Sugawarakana/Battery-Changing-Measurement/calibration/Cap.xlsx

K1 | K5 | K6 | AVG | std_avg | d | 1/d | Cap 0 | Cap 1 | Cap 2 | Cap 3 | Cap 0 | Cap 1 | Cap 2 | Cap 3 | 1/d
0 | 0 | 0 | 0 | 0 | 0.002 | 500 | 13.67882 | 13.15229875 | 13.82879 | 13.7749 | 1.367882e-11 | 1.315229875e-11 | 1.382879e-11 | 1.37749e-11 | 500
81.7 | 68.7 | 61 | 70.46666667 | 7.046666667e-05 | 0.001929533333 | 518.2600283 | 13.936275 | 13.3447125 | 14.08443625 | 13.98676875 | 1.3936275e-11 | 1.33447125e-11 | 1.408443625e-11 | 1.398676875e-11 | 518.2600283
144.3 | 142.5 | 130.4 | 139.0666667 | 0.0001390666667 | 0.001860933333 | 537.3647632 | 14.19620222 | 13.57838333 | 14.36153667 | 14.21954111 | 1.419620222e-11 | 1.357838333e-11 | 1.436153667e-11 | 1.421954111e-11 | 537.3647632
228.9 | 212.2 | 209.5 | 216.8666667 | 0.0002168666667 | 0.001783133333 | 560.8105582 | 14.49302625 | 13.8595875 | 14.6949975 | 14.50960125 | 1.449302625e-11 | 1.38595875e-11 | 1.46949975e-11 | 1.450960125e-11 | 560.8105582
293.9 | 284 | 280.4 | 286.1 | 0.0002861 | 0.0017139 | 583.4646129 | 14.80177667 | 14.14081 | 15.02806778 | 14.80580889 | 1.480177667e-11 | 1.414081e-11 | 1.502806778e-11 | 1.480580889e-11 | 583.4646129
