Sugawarakana/Battery-Changing-Measurement/(commit log)

2025-06-04 Pico code
2025-06-23 Interrupt triggered
2025-06-26 Noise Cancelling
    Use extra clock cycles to allow voltage levels to stabilize
    [Monitor.ino]
2025-09-08 Repository structure optimization
    [Pico.xlsx, variance.xlsx]
2025-09-25 Update doubleI2C.ino
    fixed wire1 style
    [doubleI2C.ino]
2025-09-26 change code to use interrupts
    change code to use interrupts still debugging.
2025-09-26 Update doubleI2C.ino
    fix reading order with timer
    [doubleI2C.ino]
2025-09-28 fixing bugs in library to use wire1
    [AD7746.cpp, AD7746.h, doubleI2C.ino]
2025-09-30 final squashy add daq
    [capacitance_dataOld.csv]
